topherCantrell/pixel-TopHat/art/glasses.docx

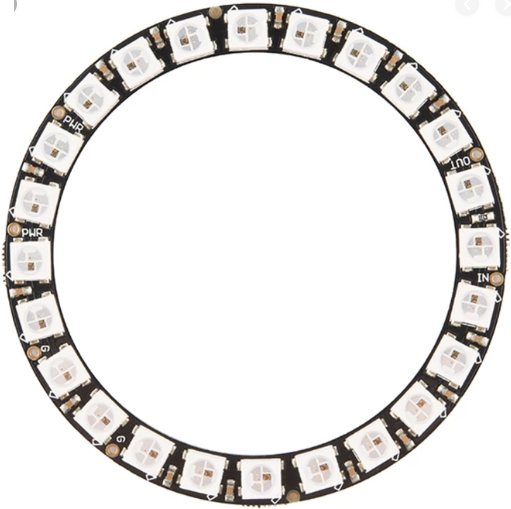
[picture p9: figure]

0

1

2

23

24

47

25
