topherCantrell/pixel-TopHat/art/sprites.docx

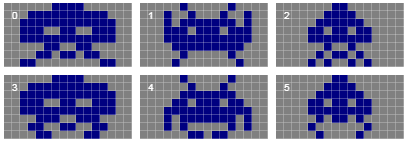
[picture p10: figure]
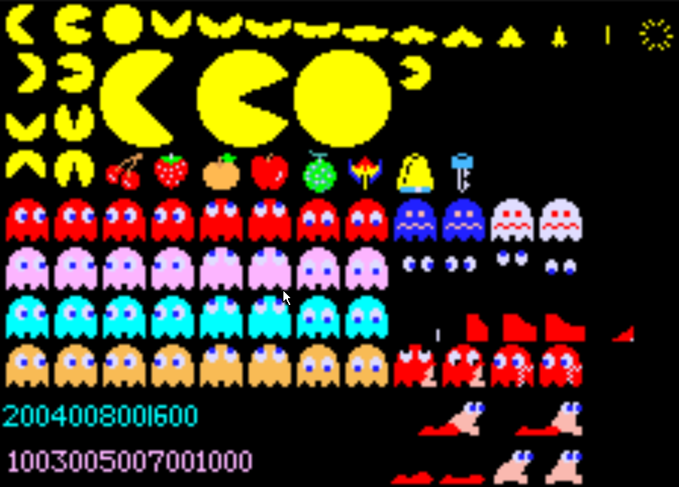
[picture p11: figure]
