topherCantrell/pixel-TopHat/art/cogs.jpg

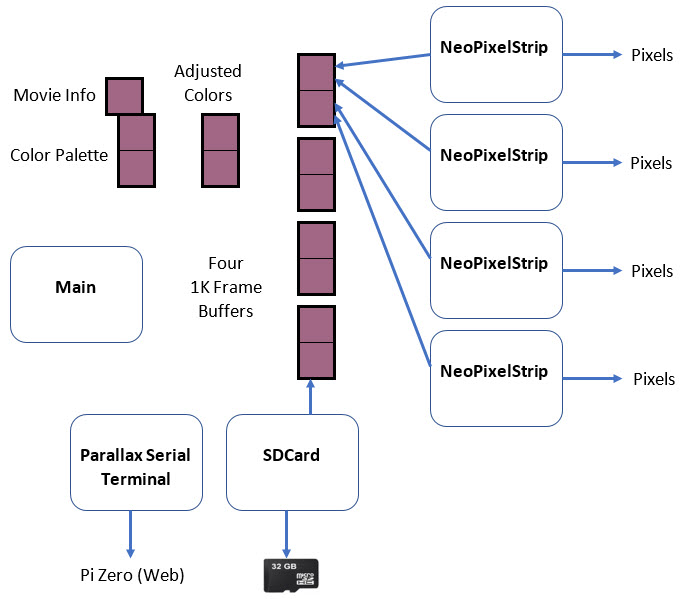
art/cogs.jpg
