topherCantrell/pixel-TopHat/art/cpus.jpg

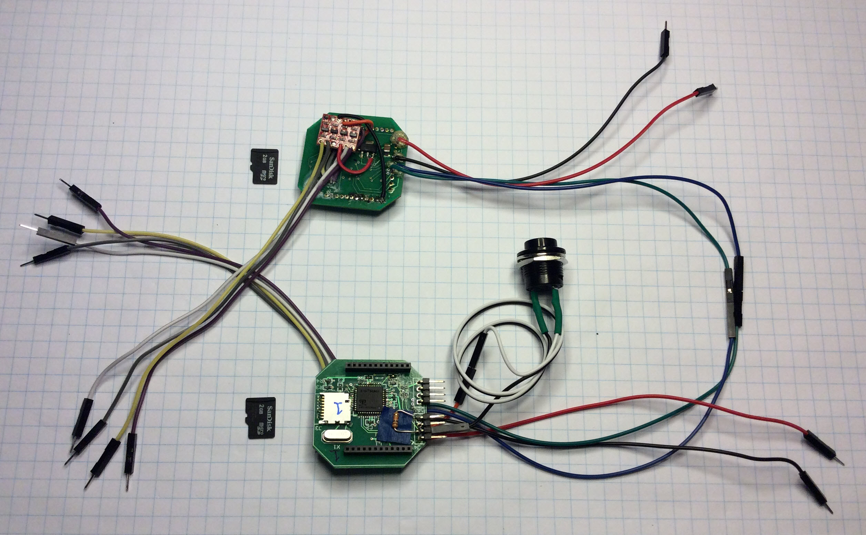
art/cpus.jpg
