topherCantrell/pixel-TopHat/art/extra1.jpg

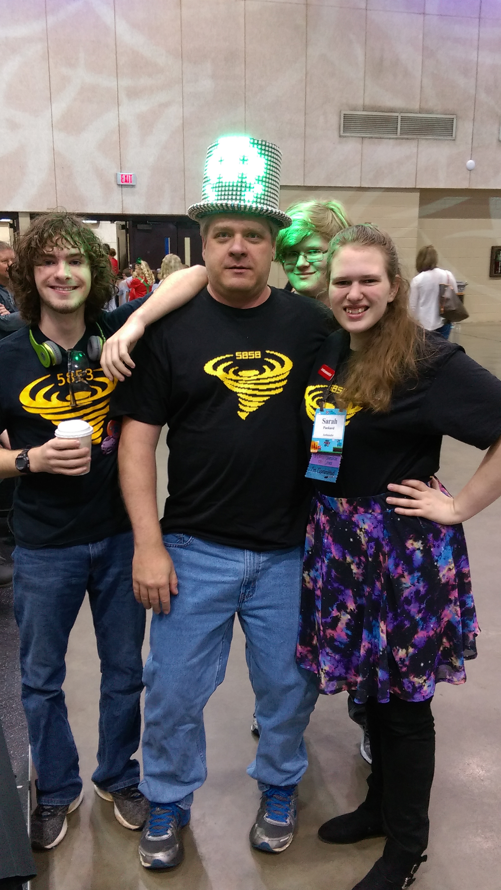
art/extra1.jpg
