topherCantrell/pixel-TopHat/art/extra2.jpg

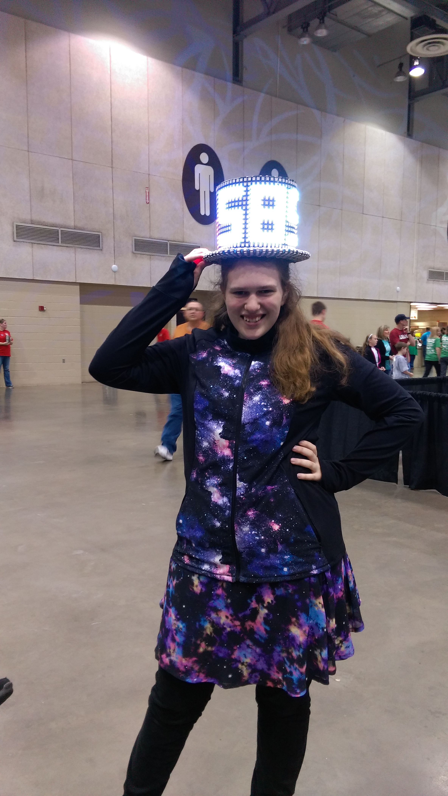
art/extra2.jpg
