topherCantrell/pixel-TopHat/art/extra3.jpg

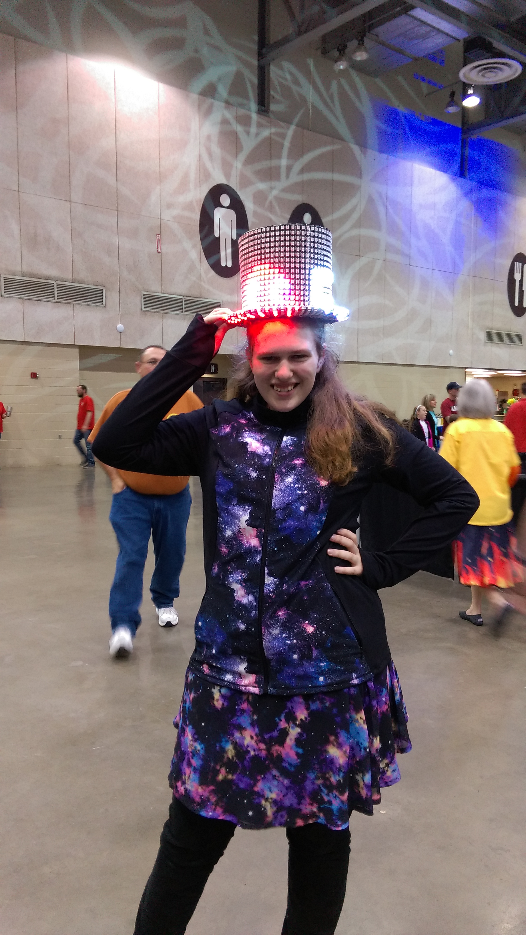
art/extra3.jpg
