topherCantrell/pixel-TopHat/art/extra5.jpg

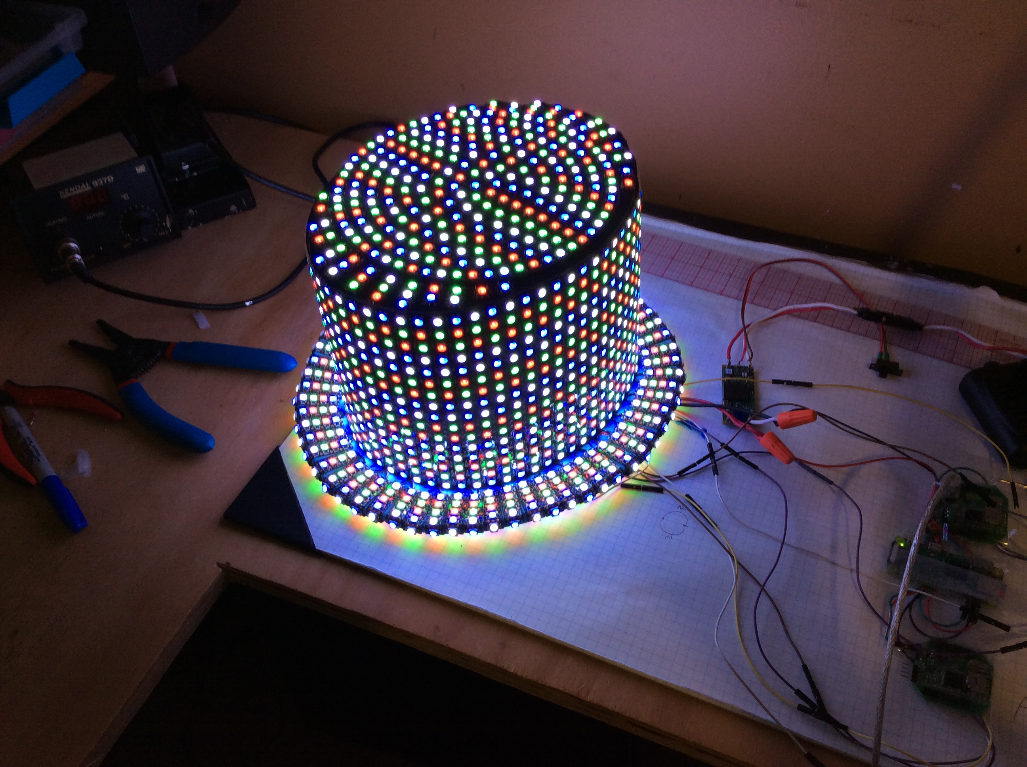
art/extra5.jpg
