topherCantrell/pixel-TopHat/art/figure1.jpg

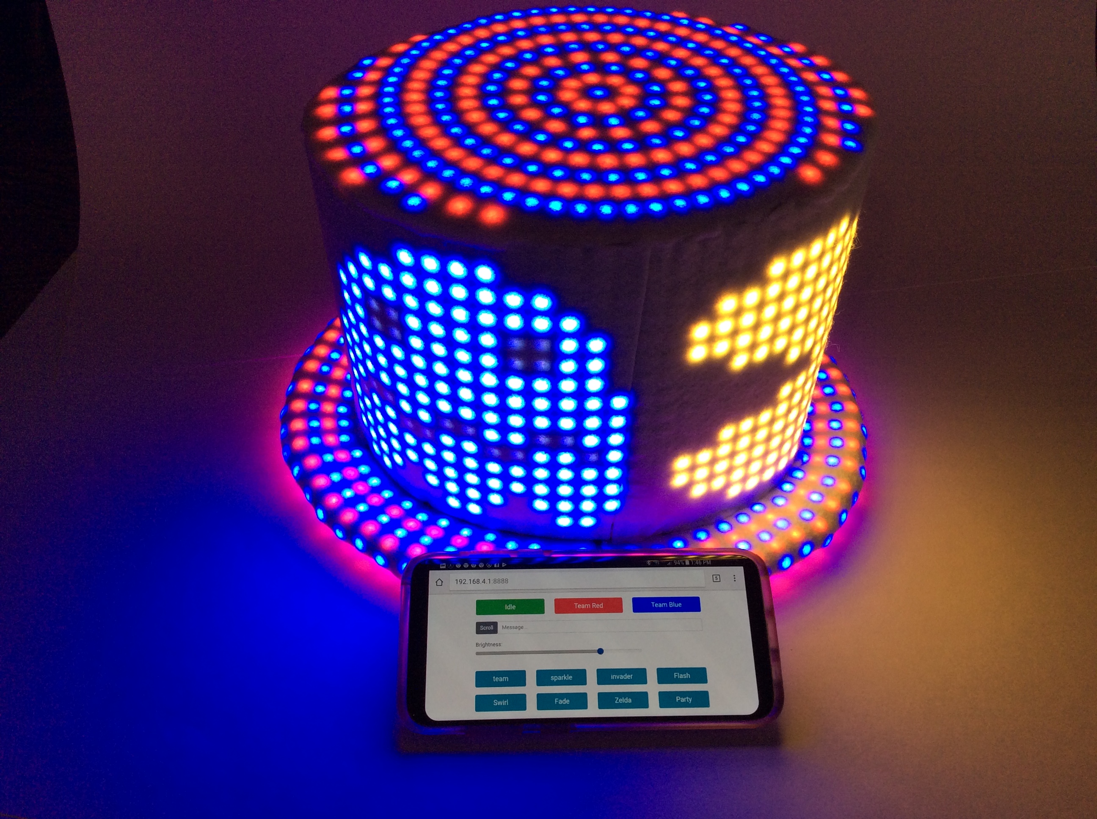
art/figure1.jpg
