topherCantrell/pixel-TopHat/art/figure5.jpg

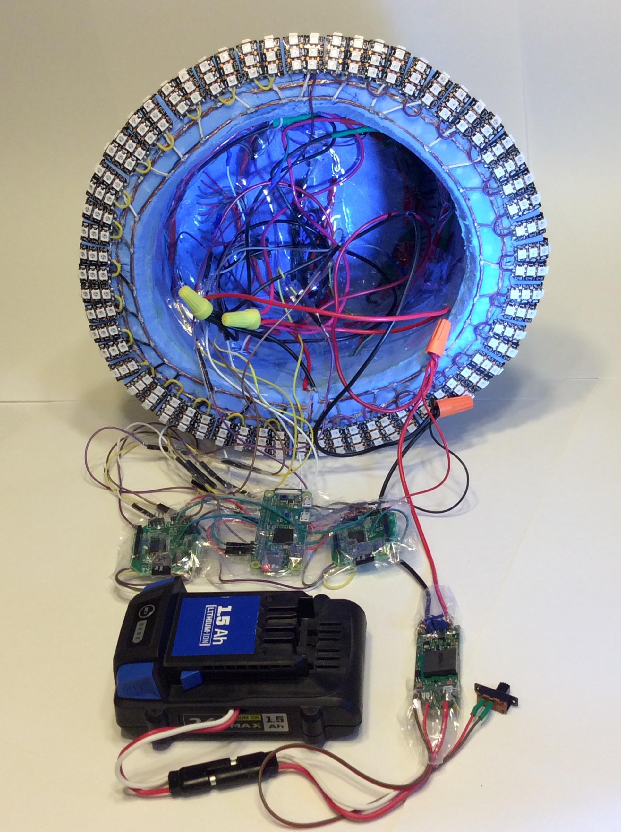
art/figure5.jpg
