topherCantrell/pixel-TopHat/art/figure8.jpg

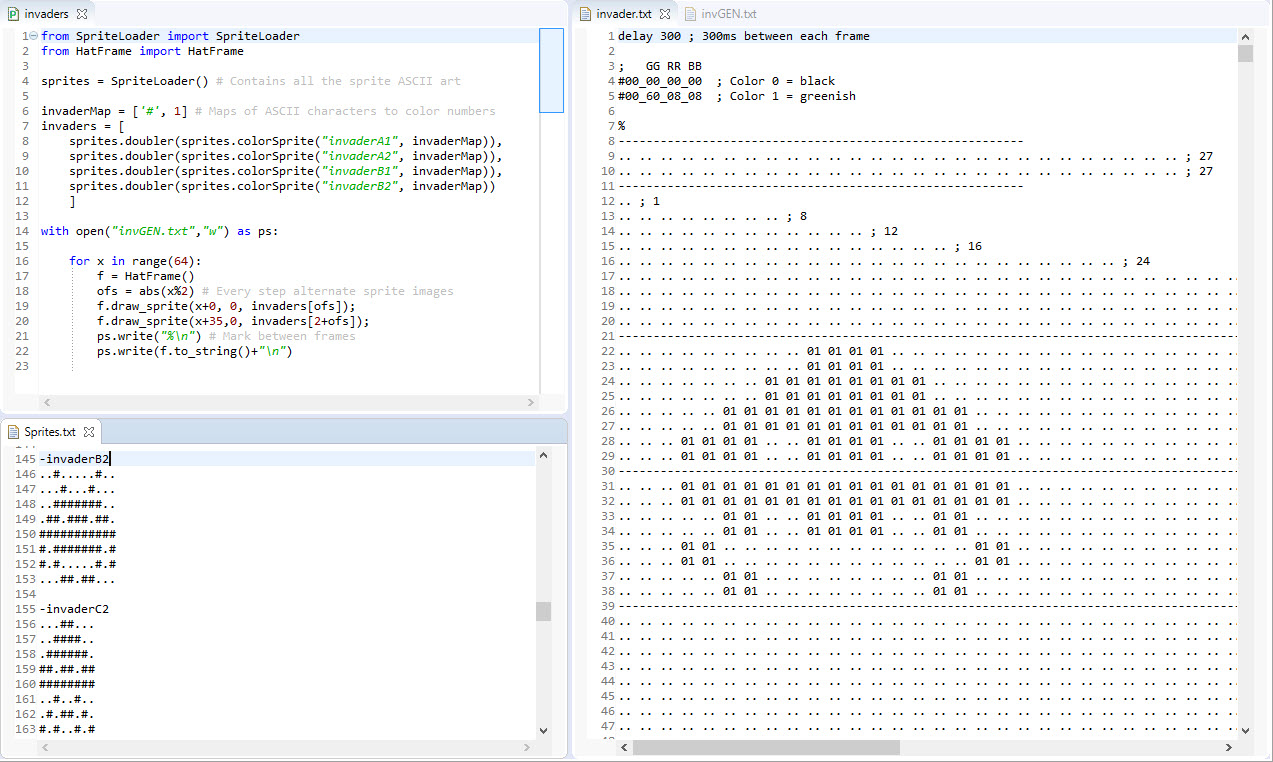
art/figure8.jpg
