topherCantrell/pixel-TopHat/art/power.jpg

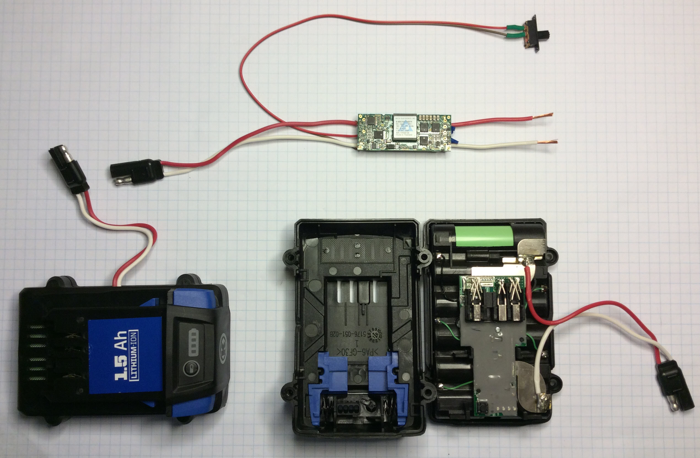
art/power.jpg
