topherCantrell/pixel-TopHat/nextGen/art/IMG_3025.jpg

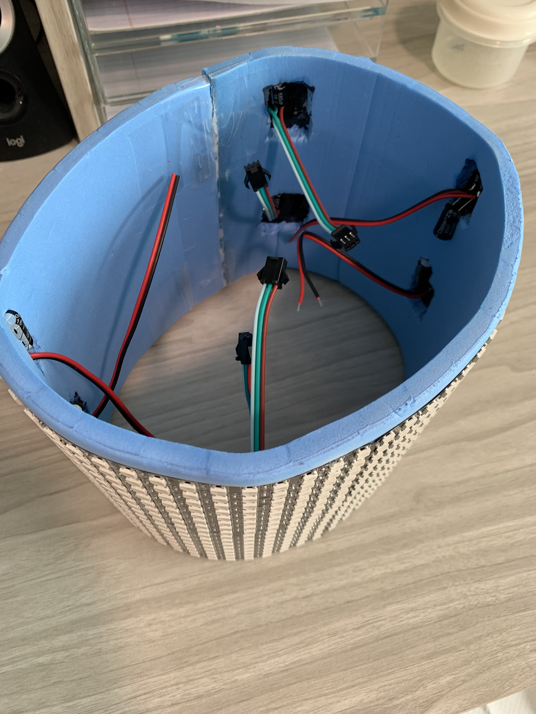
nextGen/art/IMG_3025.jpg
