topherCantrell/pixel-TopHat/nextGen/art/IMG_3026.jpg

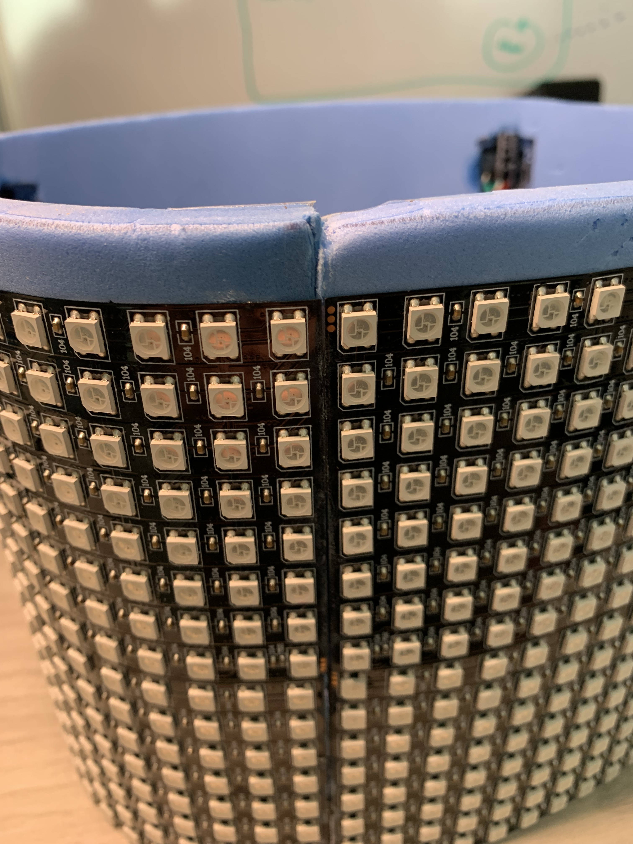
nextGen/art/IMG_3026.jpg
