topherCantrell/pixel-TopHat/nextGen/art/IMG_3028.jpg

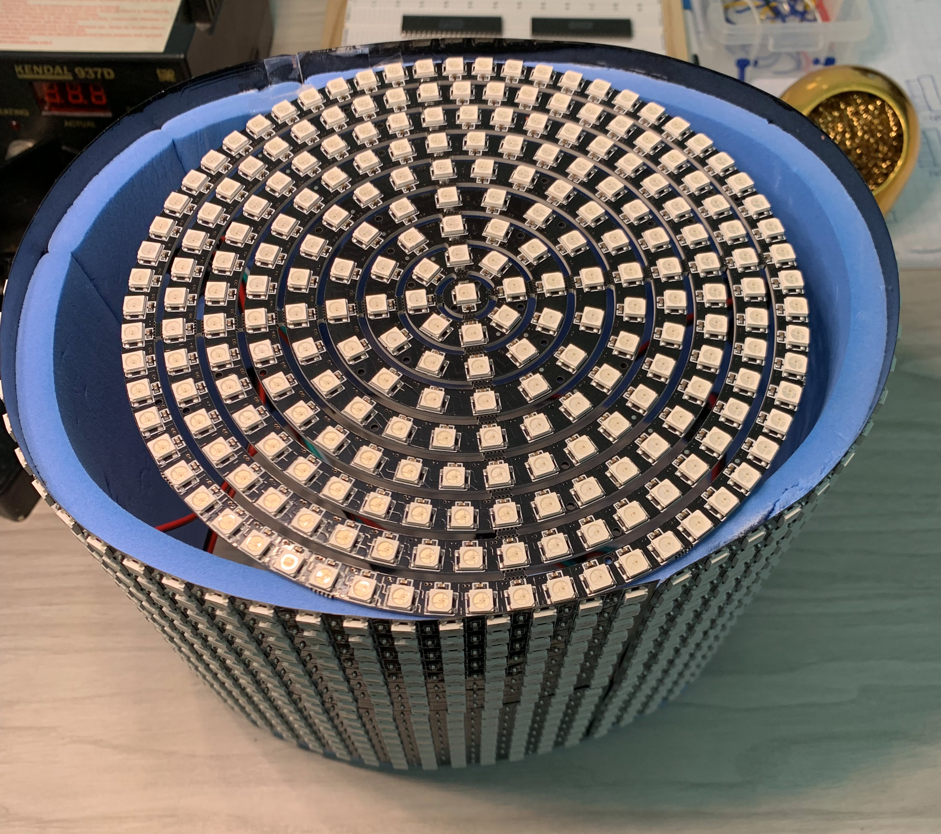
nextGen/art/IMG_3028.jpg
