topherCantrell/pixel-TopHat/nextGen/art/pixelgrid.jpg

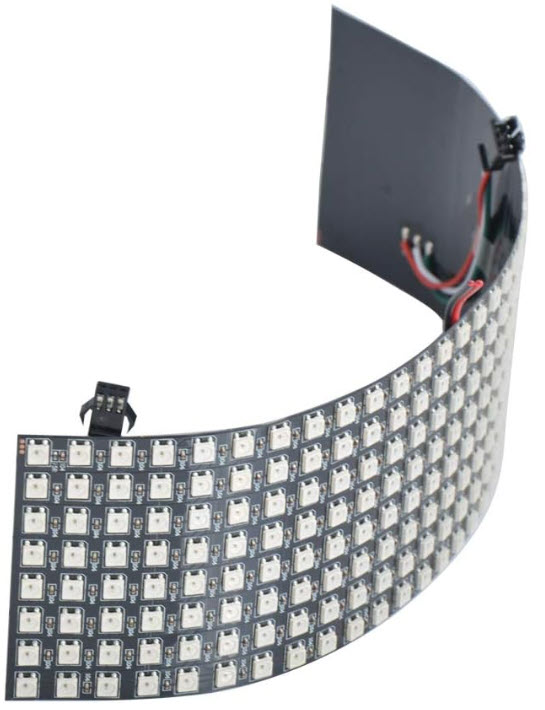
nextGen/art/pixelgrid.jpg
