topherCantrell/pixel-TopHat/nextGen/art/ring.jpg

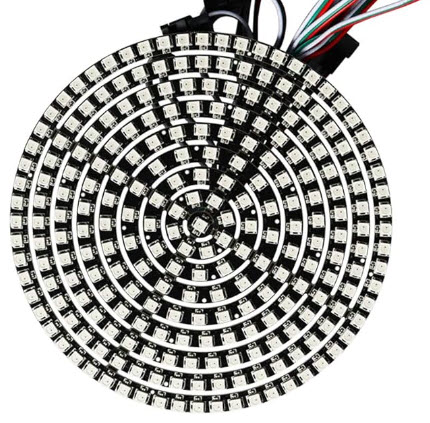
nextGen/art/ring.jpg
