topherCantrell/pixel-TopHat/CONSTRUCTION.md

# Construction

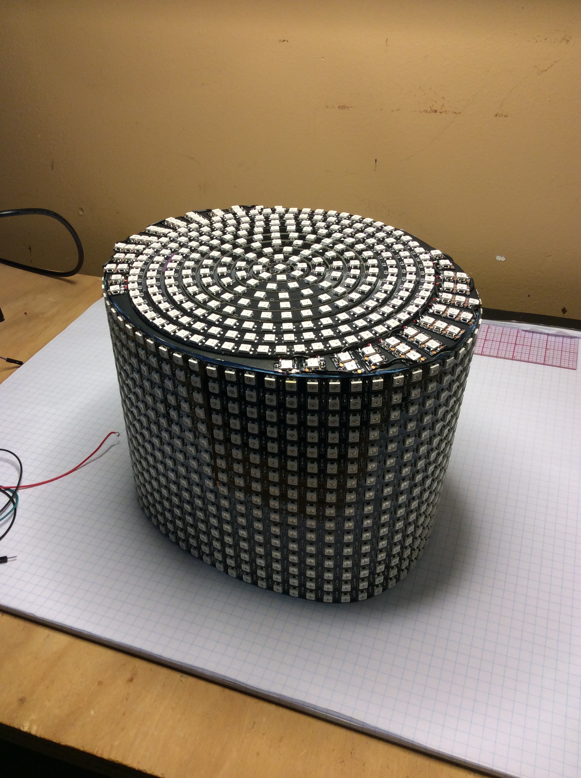
[picture p27: art/construct3.jpg]


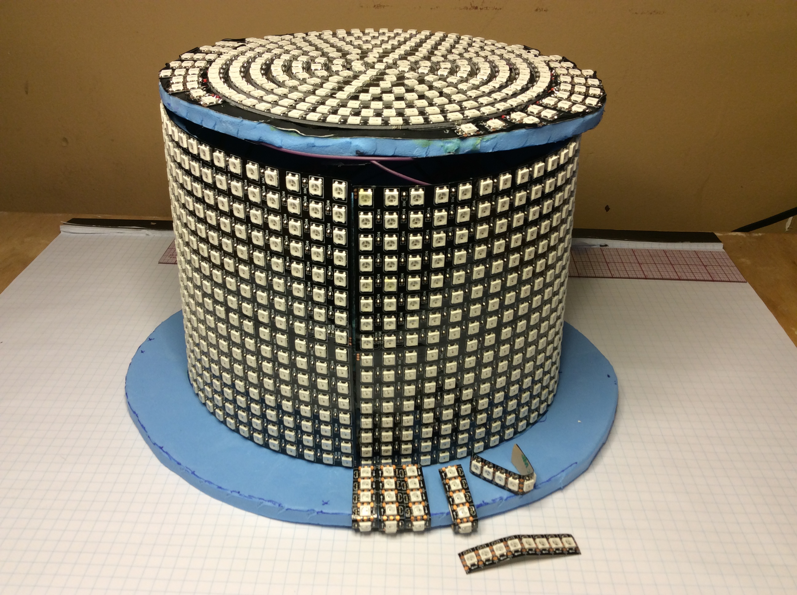
[picture p28: art/construct4.jpg]


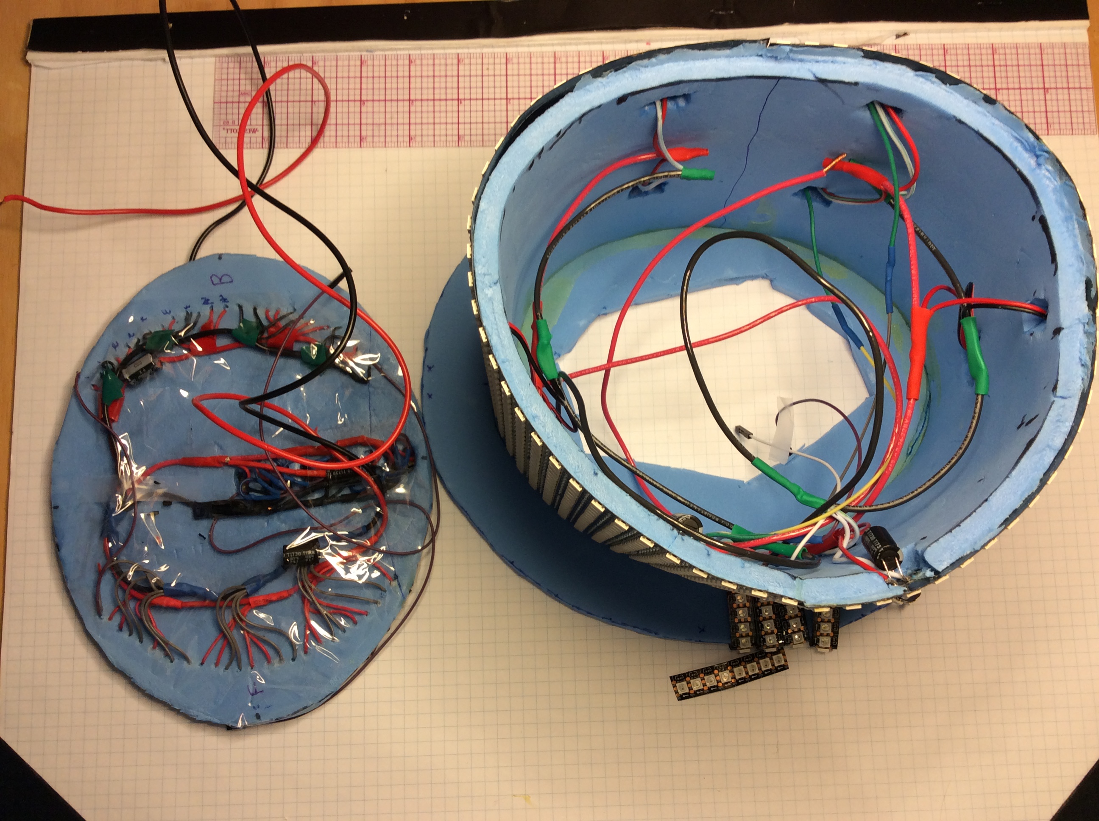
[picture p29: art/construct5.jpg]
