topherCantrell/pixel-TopHat/spin/Test.spin

CON
  _clkmode        = xtal1 + pll16x
  _xinfreq        = 5_000_000

CON
    
    pinDO   = 27
    pinSCLK = 26
    pinDI   = 25
    pinCS   = 24

OBJ    
    'STRIP    : "NeoPixelStrip"    
    PST      : "Parallax Serial Terminal"
    SD       : "SDCard"      

VAR

    byte sectorBuffer[2048]

PUB Main | i

  dira[6] := 1 ' blue

  repeat
    outa[6] := 1
    PauseMSec(5000)
    outa[6] := 0
    PauseMSec(5000)

  

  PauseMSec(2000)

  PST.start(115200)
  
  i := SD.start(@sectorBuffer, pinDO, pinSCLK, pinDI, pinCS)

  PST.hex(i,8)

  repeat  
    
PUB Main2

  ' Go ahead and drive the pixel data lines low.
  'dira[PIN_D1] := 1
  'outa[PIN_D1] := 0

  'STRIP.init

  'PauseMSec(1000)

  'STRIP.draw(2, @colors, @pixels, PIN_D1, 256)

  'repeat
    'PauseMSec(5000)
  
      
PRI PauseMSec(Duration)
  waitcnt(((clkfreq / 1_000 * Duration - 3932) #> 381) + cnt)

DAT

colors1
    long $00_00_00_00
    long $00_05_05_05

colors2
    long $00_00_00_00
    long $00_00_05_05

colors3               
    long $00_00_00_00
    long $00_05_05_00

colors4
    long $00_00_00_00
    long $00_05_00_05       

pixelPattern
    byte 1,1,0,1,1,0,1,0
    byte 0,1,0,0,1,0,1,0    
    byte 0,0,0,0,0,0,0,0
    byte 1,0,0,0,0,0,0,0
    byte 0,1,0,0,0,0,0,0
    byte 0,0,1,0,0,0,0,0
    byte 0,0,0,1,0,0,0,0
    byte 0,0,0,0,1,0,0,0
    byte 0,0,0,0,0,1,0,0
    byte 0,0,0,0,0,0,1,0
    byte 0,0,0,0,0,0,0,1
    byte 0,0,0,0,0,0,1,0
    byte 0,0,0,0,0,1,0,0
    byte 0,0,0,0,1,0,0,0
    byte 0,0,0,1,0,0,0,0
    byte 0,0,1,0,0,0,0,0 
    byte 0,1,0,0,0,0,0,0
    byte 1,0,0,0,0,0,0,0
    byte 0,1,0,0,0,0,0,0
    byte 0,0,1,0,0,0,0,0
    byte 0,0,0,1,0,0,0,0
    byte 0,0,0,0,1,0,0,0
    byte 0,0,0,0,0,1,0,0
    byte 0,0,0,0,0,0,1,0
    byte 0,0,0,0,0,0,0,1
    byte 0,0,0,0,0,0,1,0
    byte 0,0,0,0,0,1,0,0
    byte 0,0,0,0,1,0,0,0
    byte 0,0,0,1,0,0,0,0
    byte 0,0,1,0,0,0,0,0
    byte 0,1,0,0,0,0,0,0
    byte 1,1,0,0,0,1,0,1
    
