topherCantrell/pixel-TopHat/(commit log)

2017-10-24 added schematic
2017-10-27 new schematic
2017-10-27 Work on the schematic
2017-10-28 updated schematics and description
2017-11-12 test for button
2017-11-12 Updated schematic
2018-03-26 added pullup resistor to tx line -- no need to wait
2018-03-29 New Circuit Cellar labeling
